broml/Project_Emily/images/inside_inputpad.jpg

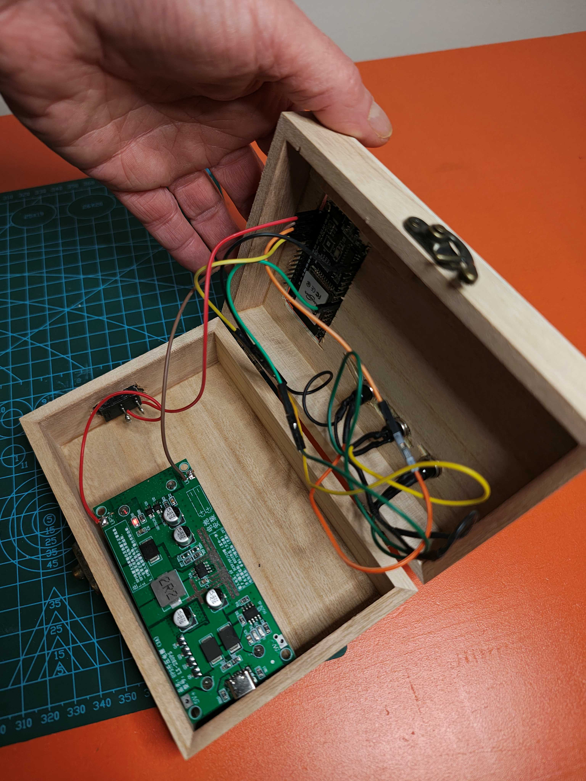
images/inside_inputpad.jpg
