broml/Project_Emily/(commit log)

2026-02-07 Add hardware guide for Emily OS v1.0
    This document provides a comprehensive guide on the hardware components required to build an Emily robot unit, detailing the system overview, bill of materials for each module, power architecture, and assembly notes.
2026-02-10 Refactor servo control and remove unused code
    Refactor servo control to use LEDC method and update related functions. Remove unused servo objects and QR scanning logic.
2026-02-10 Update print statement from 'Hello' to 'Goodbye'
2026-02-10 Fix InputPad for ESP32 v3.x compatibility
    Updated InputPad for compatibility with ESP32 v3.x and reorganized function prototypes for clarity.
    [InputPadEN.ino]
2026-02-13 Update print statement to say 'Goodbye World'
2026-02-13 Adjust tilt angles and LED timeout settings
