broml/Project_Emily/(notices)

Notices in the files:
README.md:
License: MIT
